looseygooseyrobotics/goosebrain/3dmodels/XT30PW-M.step

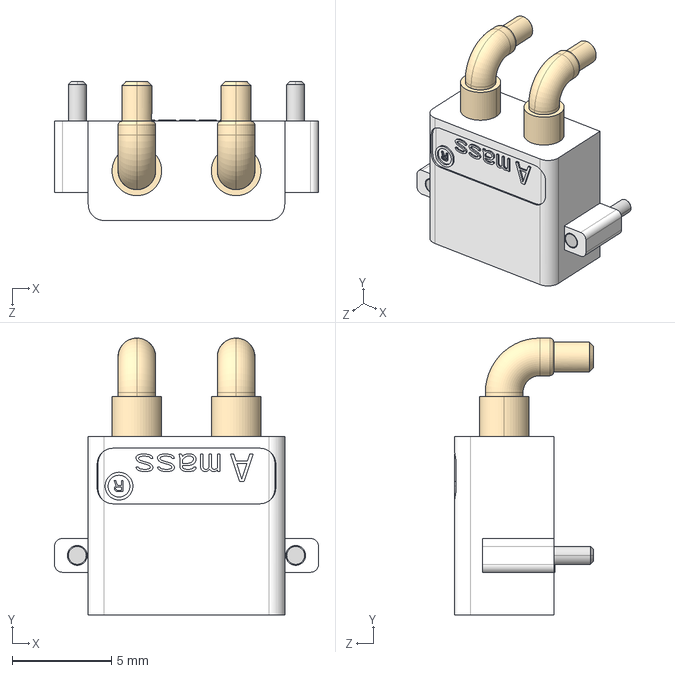
[picture p1: CAD file, 2026-11-12]
3dmodels/XT30PW-M.step
13.3 x 13.9 x 7.00 mm
