looseygooseyrobotics/goosebrain/3dmodels/2011-3X06G00RB.step

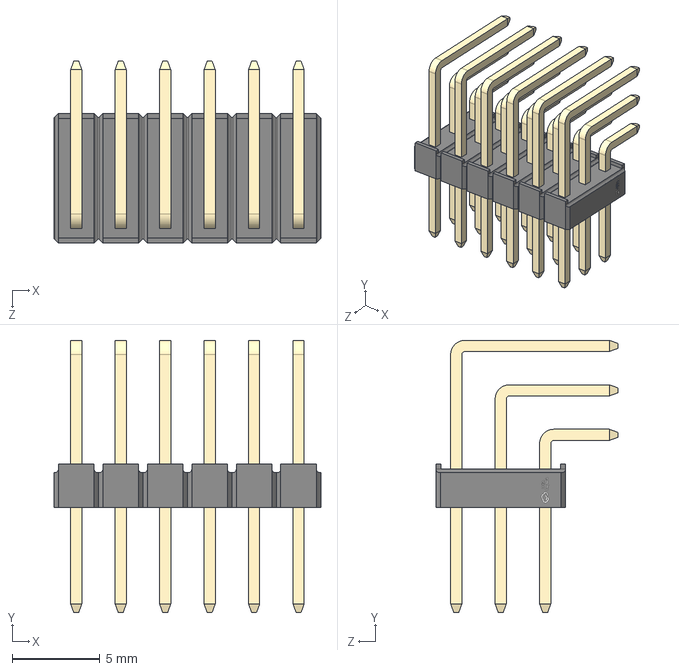
[picture p2: CAD file, 2026-11-12]
3dmodels/2011-3X06G00RB.step
15.2 x 15.6 x 10.4 mm
