looseygooseyrobotics/goosebrain/3dmodels/SK12D07VG4.step

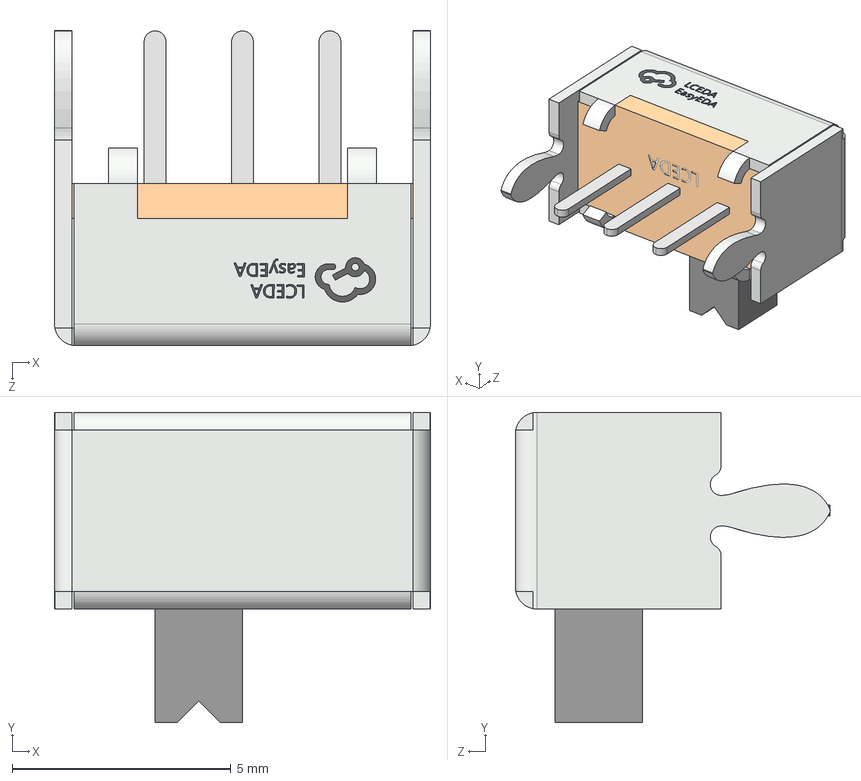
[picture p3: CAD file, 2026-11-12]
3dmodels/SK12D07VG4.step
8.60 x 7.10 x 7.19 mm
