looseygooseyrobotics/goosebrain/3dmodels/SKRTLAE010.step

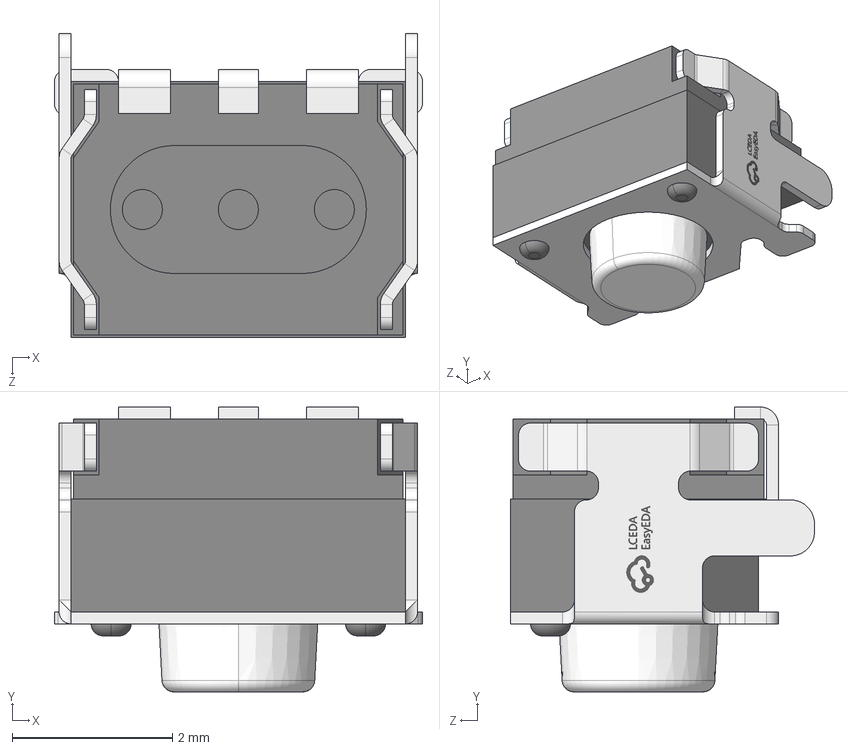
[picture p4: CAD file, 2026-11-12]
3dmodels/SKRTLAE010.step
4.60 x 3.56 x 3.80 mm
