looseygooseyrobotics/goosebrain/goosebrain.kicad_pcb

## KiCad design goosebrain.kicad_pcb (2026-11-12)

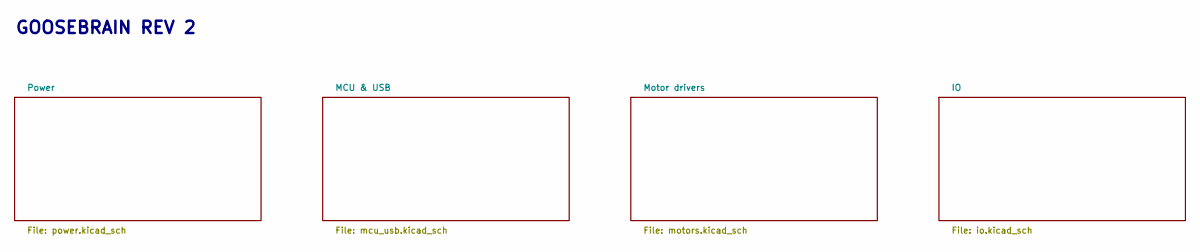
[picture p5: schematic goosebrain.kicad_sch]

Notes on the sheet:
GOOSEBRAIN REV 2

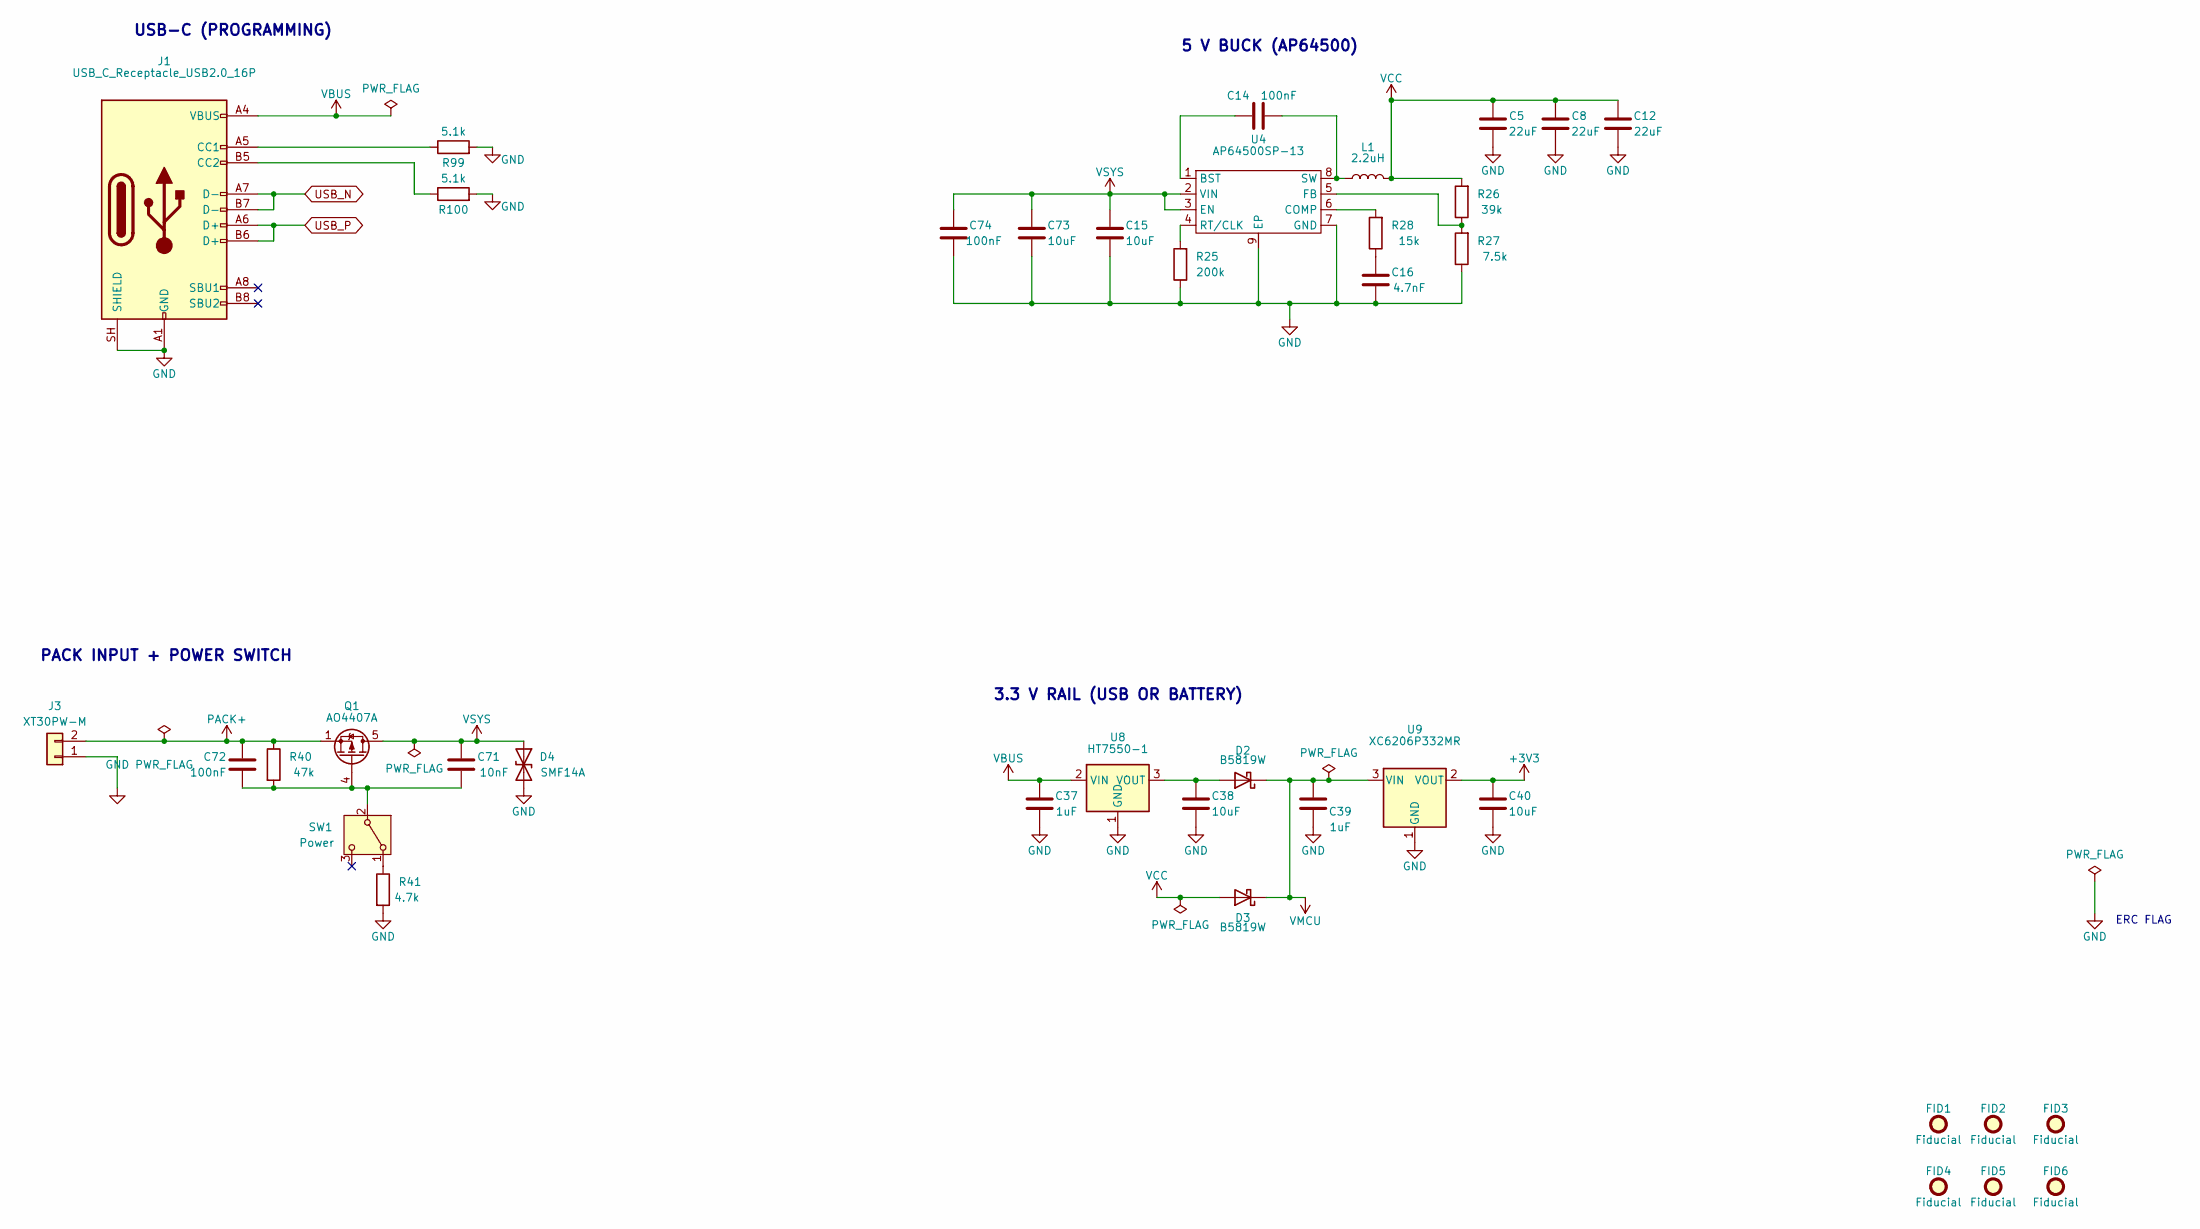
[picture p6: schematic power.kicad_sch]

Parts:
C5, C8, C12: 22uF; C_1206_3216Metric; MPN CL31A226KPHNNNE; LCSC Part # C5672
C14, C72: 100nF; C_0805_2012Metric; MPN CC0805KRX7R9BB104; LCSC Part # C49678
C15, C73: 10uF; C_0805_2012Metric; MPN CL21A106KAYNNNE; LCSC Part # C15850
C16: 4.7nF; C_0402_1005Metric; MPN 0402B472K500NT; LCSC Part # C1538
C37: 1uF; C_0603_1608Metric; MPN CL10A105KB8NNNC; LCSC Part # C15849
C38, C40: 10uF; C_0603_1608Metric; MPN CL10A106KP8NNNC; LCSC Part # C19702
C39: 1uF; C_0402_1005Metric; MPN CL05A105KA5NQNC; LCSC Part # C52923
C71: 10nF; C_0402_1005Metric; MPN CL05B103KB5NNNC; LCSC Part # C15195
C74: 100nF; C_0402_1005Metric; MPN CL05B104KB54PNC; LCSC Part # C307331
D2, D3: B5819W; D_SOD-123; MPN B5819W; LCSC Part # C64885
D4: SMF14A; D_SMF; MPN SMF14A; LCSC Part # C207256
FID1, FID2, FID3, FID4, FID5, FID6: Fiducial; Fiducial_1mm_Mask2mm
J1: USB_C_Receptacle_USB2.0_16P; USB_C_Receptacle_ShouHan_TYPE-C16PIN; MPN TYPE-C16PIN; LCSC Part # C393939
J3: XT30PW-M; AMASS_XT30PW-M_1x02_P2.50mm_Horizontal; MPN XT30PW-M30.G.Y; LCSC Part # C431092
L1: 2.2uH; L_ZengYi_HMS0530; MPN HMS0530-2R2M; LCSC Part # C18734448
Q1: AO4407A; SOIC-8_3.9x4.9mm_P1.27mm; MPN AO4407A; LCSC Part # C2841482
R25: 200k; R_0402_1005Metric; MPN 0402WGF2003TCE; LCSC Part # C25764
R26: 39k; R_0402_1005Metric; MPN 0402WGF3902TCE; LCSC Part # C25783
R27: 7.5k; R_0402_1005Metric; MPN 0402WGF7501TCE; LCSC Part # C25918
R28: 15k; R_0402_1005Metric; MPN 0402WGF1502TCE; LCSC Part # C25756
R40: 47k; R_0402_1005Metric; MPN 0402WGF4702TCE; LCSC Part # C25792
R41: 4.7k; R_0402_1005Metric; MPN 0402WGF4701TCE; LCSC Part # C25900
R99, R100: 5.1k; R_0402_1005Metric; MPN 0402WGF5101TCE; LCSC Part # C25905
SW1: Power; SW_SPDT_ShouHan_SK12D07VG4; MPN SK12D07VG4; LCSC Part # C393937
U4: AP64500SP-13; Diodes_SO-8EP; MPN AP64500SP-13; LCSC Part # C2070920
U8: HT7550-1; SOT-89-3; MPN HT7550-1; LCSC Part # C16106
U9: XC6206P332MR; SOT-23-3; MPN XC6206P332MR-G; LCSC Part # C5446

Connections:
+3V3: C40.1, U9.2 (VOUT); also elsewhere on the board
/Power/CC1: J1.A5 (CC1), R99.1
/Power/CC2: J1.B5 (CC2), R100.1
GND: C5.2, C8.2, C12.2, C15.1, C16.1, C37.2, C38.2, C39.2, C40.2, C73.1, C74.1, D4.2 (A2), J1.A1 (GND), J1.A12 (GND), J1.B1 (GND), J1.B12 (GND), J1.SH (SHIELD), J3.1, R25.1, R27.1, R41.2, R99.2, R100.2, U4.7 (GND), U4.9 (EP), U8.1 (GND), U9.1 (GND); also elsewhere on the board
unnamed: C16.2, R28.1
unnamed: C38.1, D2.2 (A), U8.3 (VOUT)
unnamed: C71.1, C72.2, Q1.4 (G), R40.2, SW1.2 (B)
unnamed: R41.1, SW1.1 (A)
unnamed: C14.2, U4.1 (BST)
unnamed: R28.2, U4.6 (COMP)
unnamed: R26.1, R27.2, U4.5 (FB)
unnamed: R25.2, U4.4 (RT/CLK)
unnamed: C14.1, L1.1, U4.8 (SW)
PACK+: C72.1, J3.2, Q1.1 (S), Q1.2 (S), Q1.3 (S), R40.1
VBUS: C37.1, J1.A4 (VBUS), J1.A9 (VBUS), J1.B4 (VBUS), J1.B9 (VBUS), U8.2 (VIN)
VCC: C5.1, C8.1, C12.1, D3.2 (A), L1.2, R26.2; also elsewhere on the board
VMCU: C39.1, D2.1 (K), D3.1 (K), U9.3 (VIN); also elsewhere on the board
VSYS: C15.2, C71.2, C73.2, C74.2, D4.1 (A1), Q1.5 (D), Q1.6 (D), Q1.7 (D), Q1.8 (D), U4.2 (VIN), U4.3 (EN); also elsewhere on the board

Notes on the sheet:
ERC FLAG
3.3 V RAIL (USB OR BATTERY)
5 V BUCK (AP64500)
USB-C (PROGRAMMING)
PACK INPUT + POWER SWITCH

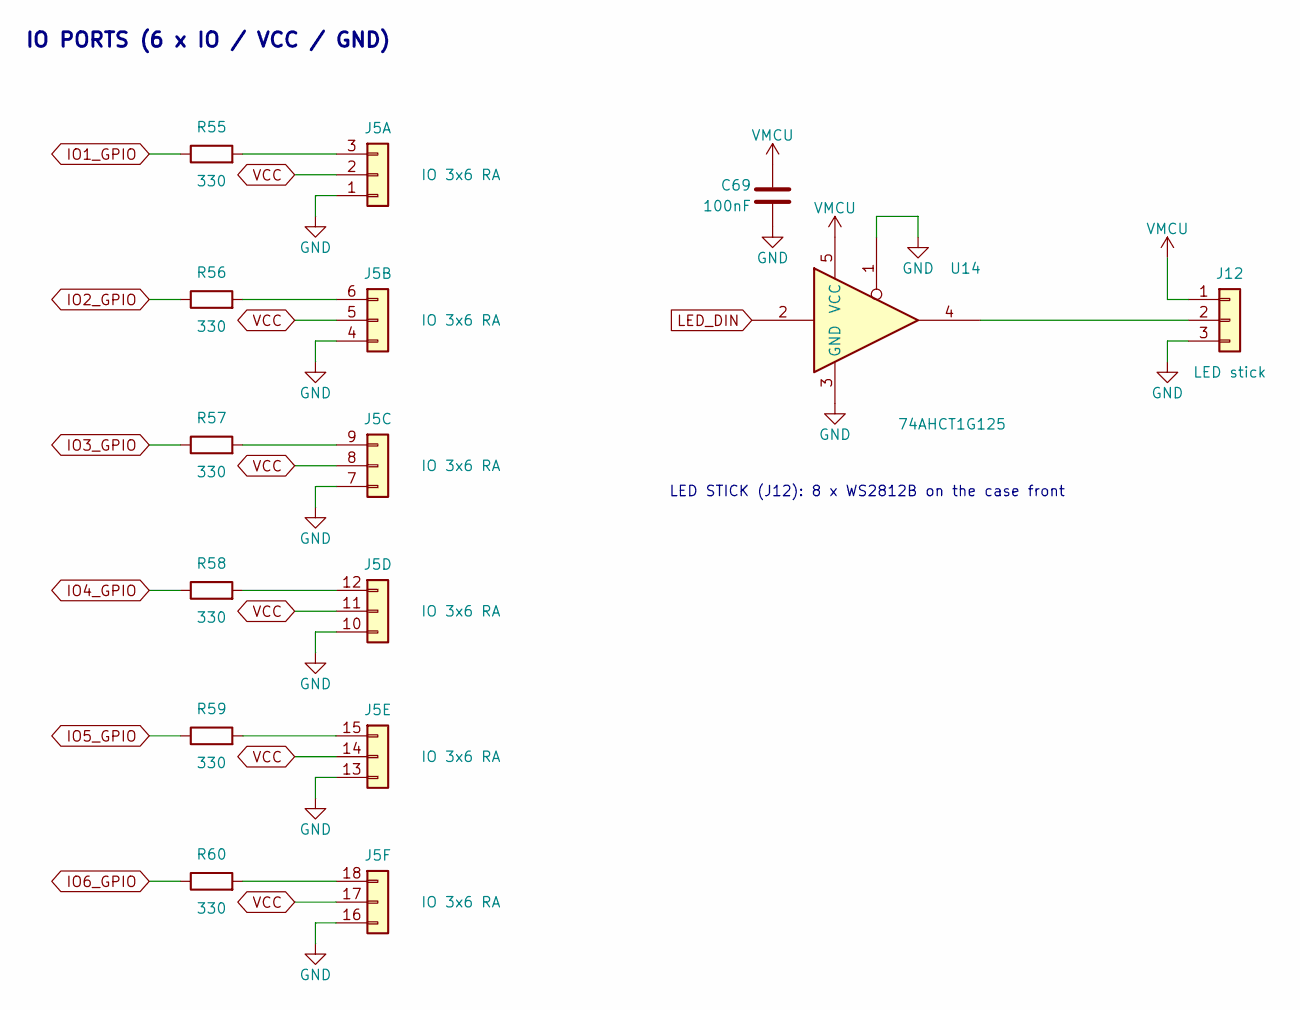
[picture p7: schematic io.kicad_sch]

Parts:
C69: 100nF; C_0402_1005Metric; MPN CL05B104KO5NNNC; LCSC Part # C1525
J5: IO 3x6 RA; PinHeader_3x06_P2.54mm_Horizontal_WingTAT; MPN 2011-3X06G00RB; LCSC Part # C51953246
J12: LED stick; JST_PH_B3B-PH-K_1x03_P2.00mm_Vertical; MPN B3B-PH-K-S(LF)(SN); LCSC Part # C131339
R55, R56, R57, R58, R59, R60: 330; R_0402_1005Metric; MPN 0402WGF3300TCE; LCSC Part # C25104
U14: 74AHCT1G125; SOT-23-5; MPN SN74AHCT1G125DBVR; LCSC Part # C20617903

Connections:
GND: C69.2, J5.1 (GND), J5.4 (GND), J5.7 (GND), J5.10 (GND), J5.13 (GND), J5.16 (GND), J12.3, U14.1, U14.3 (GND); also elsewhere on the board
IO1_GPIO: R55.1; also elsewhere on the board
IO2_GPIO: R56.1; also elsewhere on the board
IO3_GPIO: R57.1; also elsewhere on the board
IO4_GPIO: R58.1; also elsewhere on the board
IO5_GPIO: R59.1; also elsewhere on the board
IO6_GPIO: R60.1; also elsewhere on the board
LED_DIN: U14.2; also elsewhere on the board
unnamed: J5.3 (SIG), R55.2
unnamed: J5.6 (SIG), R56.2
unnamed: J5.9 (SIG), R57.2
unnamed: J5.12 (SIG), R58.2
unnamed: J5.15 (SIG), R59.2
unnamed: J5.18 (SIG), R60.2
unnamed: J12.2, U14.4
VCC: J5.2 (5V), J5.5 (5V), J5.8 (5V), J5.11 (5V), J5.14 (5V), J5.17 (5V); also elsewhere on the board
VMCU: C69.1, J12.1, U14.5 (VCC); also elsewhere on the board

Notes on the sheet:
LED STICK (J12): 8 x WS2812B on the case front
IO PORTS (6 x IO / VCC / GND)

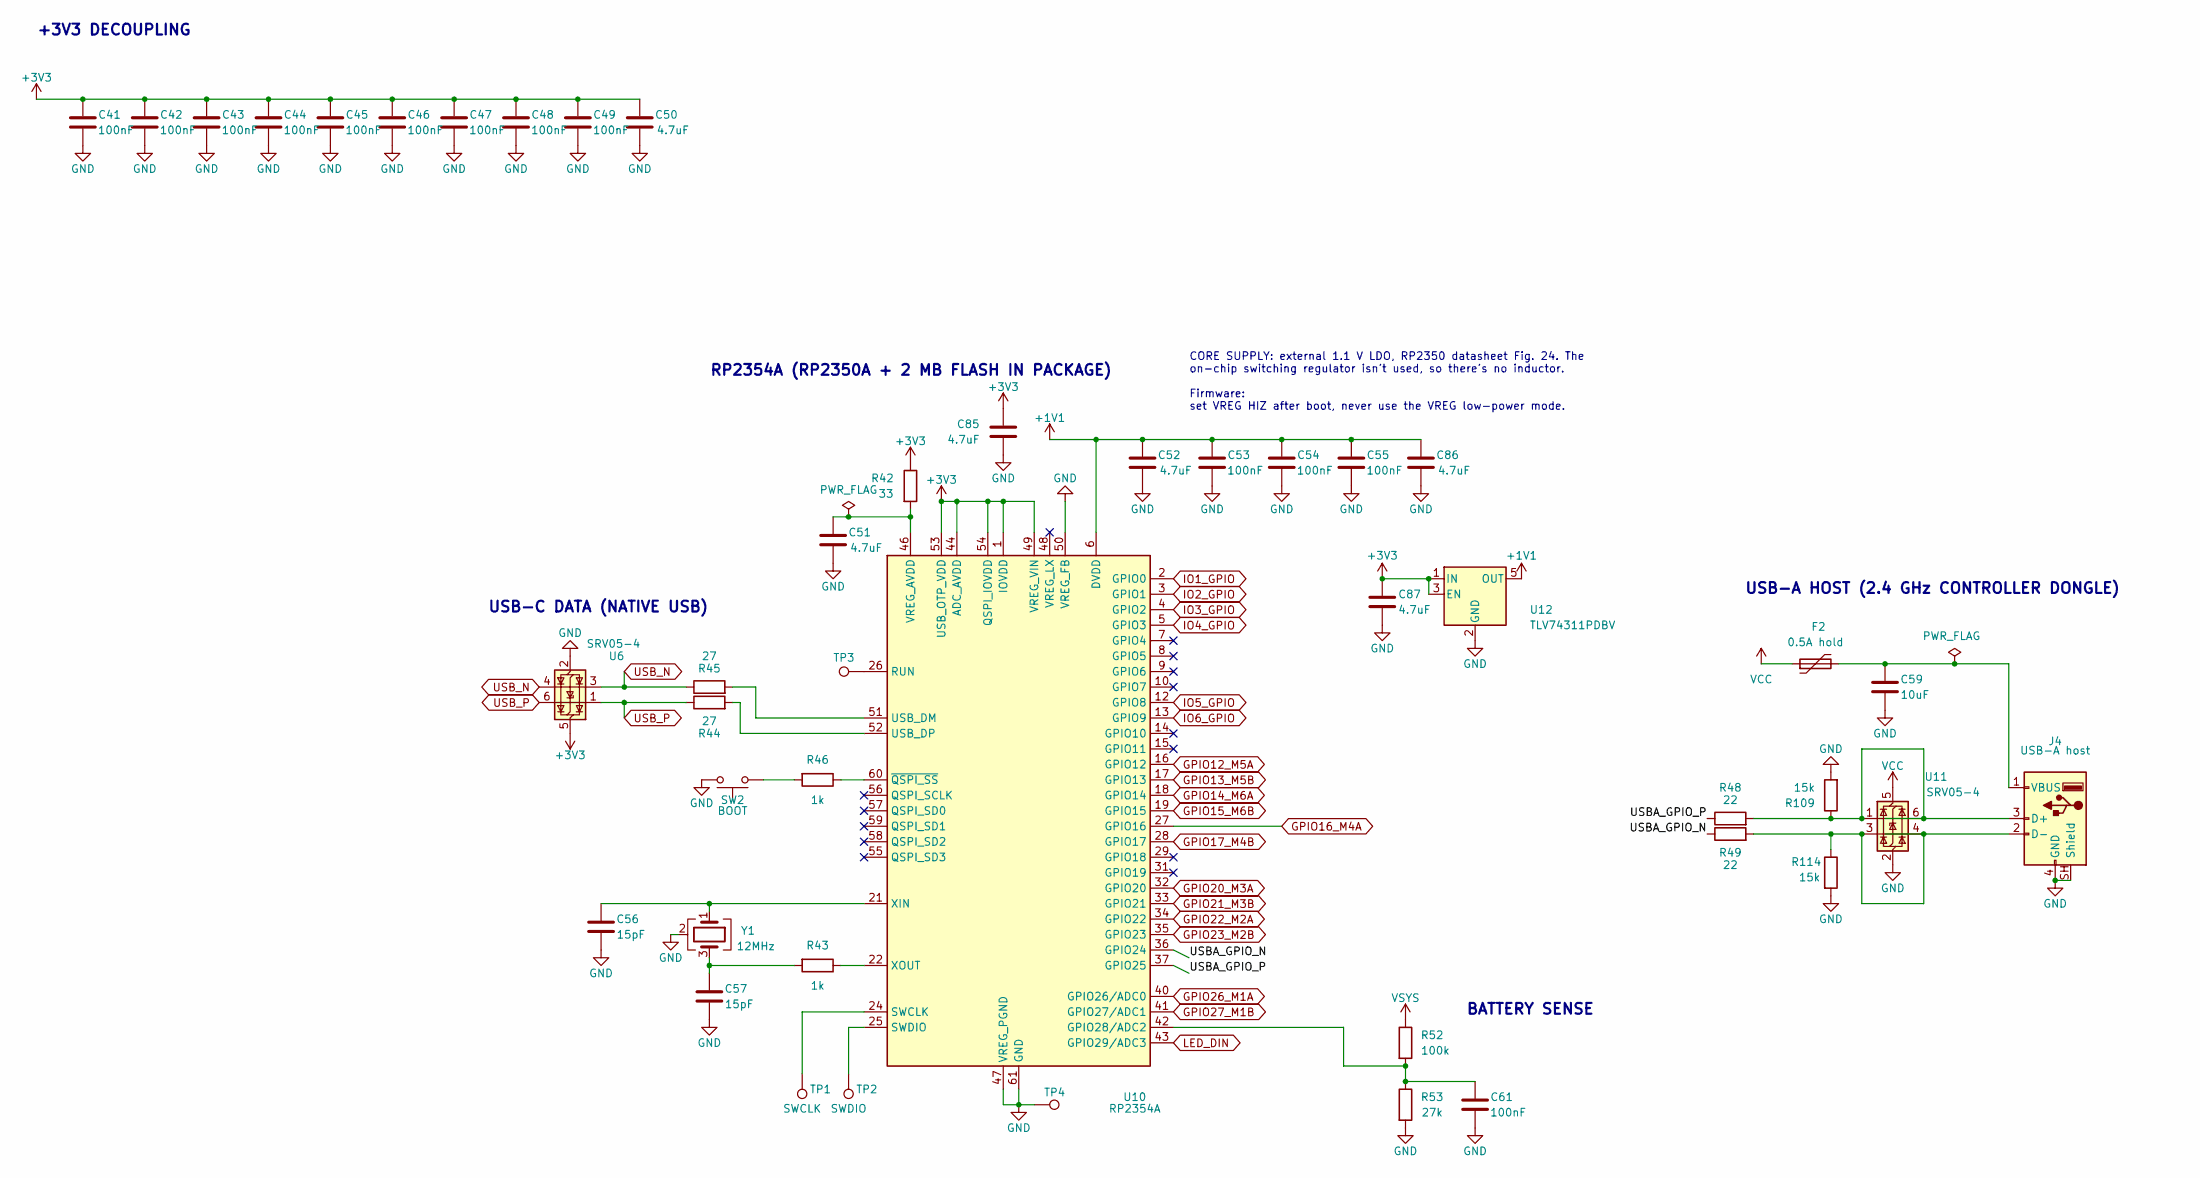
[picture p8: schematic mcu_usb.kicad_sch]

Parts:
C41, C42, C43, C44, C45, C46, C47, C48, C49, C53, C54, C55, C61: 100nF; C_0402_1005Metric; MPN CL05B104KO5NNNC; LCSC Part # C1525
C50, C51, C52, C85, C86, C87: 4.7uF; C_0402_1005Metric; MPN CL05A475MP5NRNC; LCSC Part # C23733
C56, C57: 15pF; C_0402_1005Metric; MPN 0402CG150J500NT; LCSC Part # C1548
C59: 10uF; C_0805_2012Metric; MPN CL21A106KAYNNNE; LCSC Part # C15850
F2: 0.5A hold; Fuse_1206_3216Metric; MPN JK-nSMD050-16; LCSC Part # C2680506
J4: USB-A host; USB_A_ShouHan_AF90_WJDG; MPN AF 90 WJDG; LCSC Part # C456018
R42: 33; R_0402_1005Metric; MPN 0402WGF330JTCE; LCSC Part # C25105
R43, R46: 1k; R_0402_1005Metric; MPN 0402WGF1001TCE; LCSC Part # C11702
R44, R45: 27; R_0603_1608Metric; MPN 0603WAF270JT5E; LCSC Part # C25190
R48, R49: 22; R_0402_1005Metric; MPN 0402WGF220JTCE; LCSC Part # C25092
R52: 100k; R_0402_1005Metric; MPN 0402WGF1003TCE; LCSC Part # C25741
R53: 27k; R_0402_1005Metric; MPN 0402WGF2702TCE; LCSC Part # C25771
R109, R114: 15k; R_0402_1005Metric; MPN 0402WGF1502TCE; LCSC Part # C25756
SW2: BOOT; SW_Push_1P1T-MP_NO_Horizontal_Alps_SKRTLAE010_JLC; MPN SKRTLAE010; LCSC Part # C110293
TP1: SWCLK; TestPoint_Pad_D1.0mm
TP2: SWDIO; TestPoint_Pad_D1.0mm
TP3: RUN; TestPoint_Pad_D1.0mm
TP4: GND; TestPoint_Pad_D1.0mm
U6, U11: SRV05-4; SOT-23-6; MPN SRV05-4; LCSC Part # C7420376
U10: RP2354A; QFN-60-1EP_7x7mm_P0.4mm_EP3.4x3.4mm; MPN RP2354A; LCSC Part # C41378174
U12: TLV74311PDBV; SOT-23-5; MPN TLV74311PDBVR; LCSC Part # C485147
Y1: 12MHz; Crystal_SMD_3225-4Pin_3.2x2.5mm; MPN ABM8-272-T3; LCSC Part # C20625731

Connections:
+1V1: C52.1, C53.1, C54.1, C55.1, C86.1, U10.6 (DVDD), U10.23 (DVDD), U10.39 (DVDD), U12.5 (OUT)
+3V3: C41.1, C42.1, C43.1, C44.1, C45.1, C46.1, C47.1, C48.1, C49.1, C50.1, C85.1, C87.1, R42.1, U6.5 (VP), U10.1 (IOVDD), U10.11 (IOVDD), U10.20 (IOVDD), U10.30 (IOVDD), U10.38 (IOVDD), U10.44 (ADC_AVDD), U10.45 (IOVDD), U10.49 (VREG_VIN), U10.53 (USB_OTP_VDD), U10.54 (QSPI_IOVDD), U12.1 (IN), U12.3 (EN); also elsewhere on the board
/MCU & USB/BAT_SENSE: C61.1, R52.2, R53.1, U10.42 (GPIO28/ADC2)
/MCU & USB/RUN: TP3.1 (1_1), U10.26 (RUN)
/MCU & USB/USBA_GPIO_N: R49.1, U10.36 (GPIO24)
/MCU & USB/USBA_GPIO_P: R48.1, U10.37 (GPIO25)
/MCU & USB/USBA_N: J4.2 (D-), R49.2, R114.1, U11.3 (IO2), U11.4 (IO3)
/MCU & USB/USBA_P: J4.3 (D+), R48.2, R109.1, U11.1 (IO1), U11.6 (IO4)
GND: C41.2, C42.2, C43.2, C44.2, C45.2, C46.2, C47.2, C48.2, C49.2, C50.2, C51.2, C52.2, C53.2, C54.2, C55.2, C56.2, C57.2, C59.2, C61.2, C85.2, C86.2, C87.2, J4.4 (GND), J4.SH (Shield), R53.2, R109.2, R114.2, SW2.2, TP4.1 (1_1), U6.2 (VN), U10.47 (VREG_PGND), U10.50 (VREG_FB), U10.61 (GND), U11.2 (VN), U12.2 (GND), Y1.2 (G), Y1.4 (G); also elsewhere on the board
GPIO12_M5A: U10.16 (GPIO12); also elsewhere on the board
GPIO13_M5B: U10.17 (GPIO13); also elsewhere on the board
GPIO14_M6A: U10.18 (GPIO14); also elsewhere on the board
GPIO15_M6B: U10.19 (GPIO15); also elsewhere on the board
GPIO16_M4A: U10.27 (GPIO16); also elsewhere on the board
GPIO17_M4B: U10.28 (GPIO17); also elsewhere on the board
GPIO20_M3A: U10.32 (GPIO20); also elsewhere on the board
GPIO21_M3B: U10.33 (GPIO21); also elsewhere on the board
GPIO22_M2A: U10.34 (GPIO22); also elsewhere on the board
GPIO23_M2B: U10.35 (GPIO23); also elsewhere on the board
GPIO26_M1A: U10.40 (GPIO26/ADC0); also elsewhere on the board
GPIO27_M1B: U10.41 (GPIO27/ADC1); also elsewhere on the board
IO1_GPIO: U10.2 (GPIO0); also elsewhere on the board
IO2_GPIO: U10.3 (GPIO1); also elsewhere on the board
IO3_GPIO: U10.4 (GPIO2); also elsewhere on the board
IO4_GPIO: U10.5 (GPIO3); also elsewhere on the board
IO5_GPIO: U10.12 (GPIO8); also elsewhere on the board
IO6_GPIO: U10.13 (GPIO9); also elsewhere on the board
LED_DIN: U10.43 (GPIO29/ADC3); also elsewhere on the board
unnamed: C57.1, R43.2, Y1.3
unnamed: C59.1, F2.2, J4.1 (VBUS)
unnamed: R46.2, SW2.1
unnamed: TP1.1 (1_1), U10.24 (SWCLK)
unnamed: TP2.1 (1_1), U10.25 (SWDIO)
unnamed: C51.1, R42.2, U10.46 (VREG_AVDD)
unnamed: C56.1, U10.21 (XIN), Y1.1
unnamed: R43.1, U10.22 (XOUT)
unnamed: R46.1, U10.60 (~QSPI_SS)
VCC: F2.1, U11.5 (VP); also elsewhere on the board
VSYS: R52.1; also elsewhere on the board

Notes on the sheet:
RP2354A (RP2350A + 2 MB FLASH IN PACKAGE)
+3V3 DECOUPLING
CORE SUPPLY: external 1.1 V LDO, RP2350 datasheet Fig. 24. The on-chip switching regulator isn't used, so there's no inductor. Firmware: set VREG HIZ after boot, never use the VREG low-power mode.
BATTERY SENSE
USB-C DATA (NATIVE USB)
USB-A HOST (2.4 GHz CONTROLLER DONGLE)

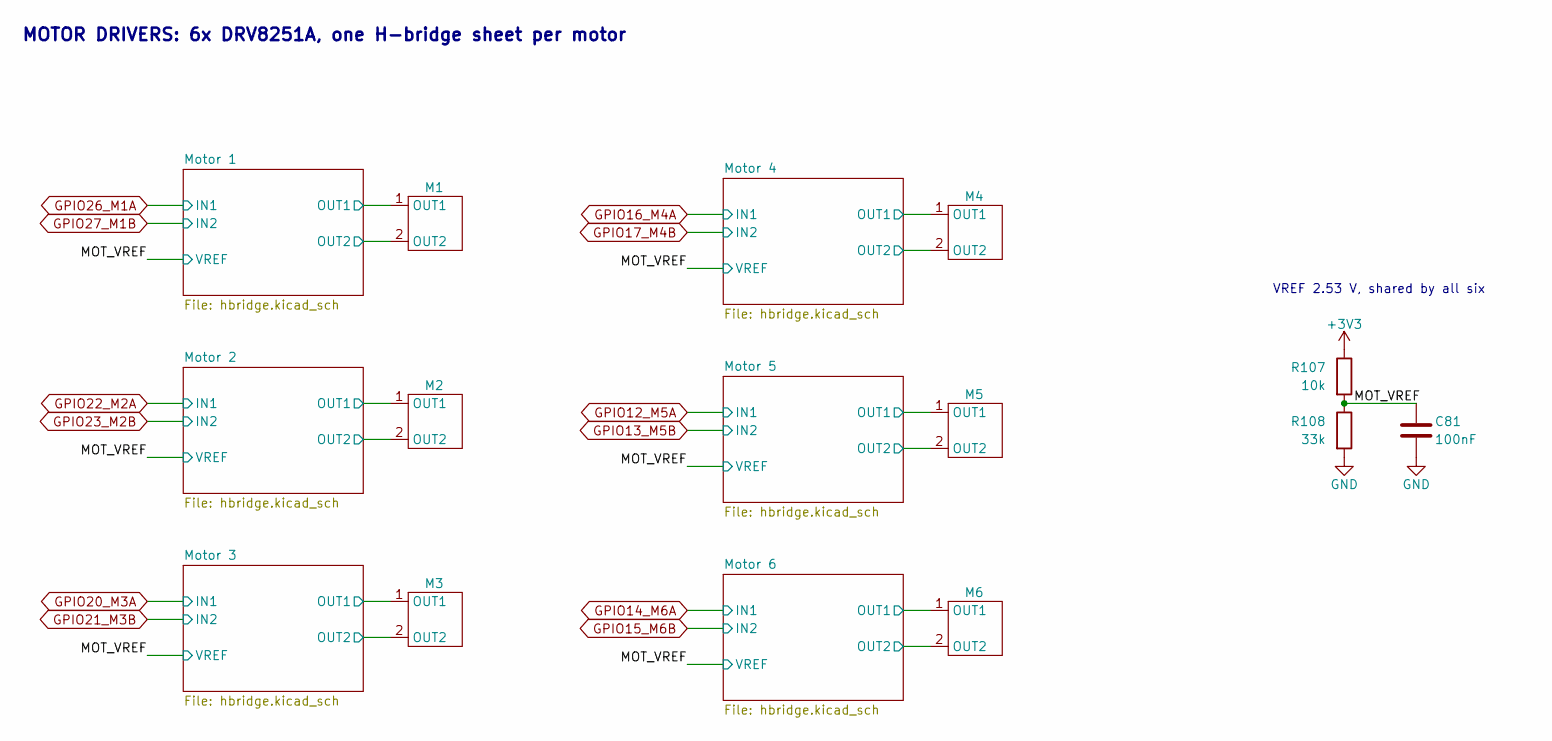
[picture p9: schematic motors.kicad_sch]

Parts:
C81: 100nF; C_0402_1005Metric; MPN CL05B104KO5NNNC; LCSC Part # C1525
M1, M2, M3, M4, M5, M6: JST_PH_S2B-PH-K_1x02_P2.00mm_Horizontal; MPN S2B-PH-K-S(LF)(SN); LCSC Part # C173752
R107: 10k; R_0402_1005Metric; MPN 0402WGF1002TCE; LCSC Part # C25744
R108: 33k; R_0402_1005Metric; MPN 0402WGF3302TCE; LCSC Part # C25779

Connections:
+3V3: R107.1; also elsewhere on the board
/Motor drivers/MOT_VREF: C81.1, R107.2, R108.1; also elsewhere on the board
/Motor drivers/Motor 1/OUT1: M1.1 (OUT1); also elsewhere on the board
/Motor drivers/Motor 1/OUT2: M1.2 (OUT2); also elsewhere on the board
/Motor drivers/Motor 2/OUT1: M2.1 (OUT1); also elsewhere on the board
/Motor drivers/Motor 2/OUT2: M2.2 (OUT2); also elsewhere on the board
/Motor drivers/Motor 3/OUT1: M3.1 (OUT1); also elsewhere on the board
/Motor drivers/Motor 3/OUT2: M3.2 (OUT2); also elsewhere on the board
/Motor drivers/Motor 4/OUT1: M4.1 (OUT1); also elsewhere on the board
/Motor drivers/Motor 4/OUT2: M4.2 (OUT2); also elsewhere on the board
/Motor drivers/Motor 5/OUT1: M5.1 (OUT1); also elsewhere on the board
/Motor drivers/Motor 5/OUT2: M5.2 (OUT2); also elsewhere on the board
/Motor drivers/Motor 6/OUT1: M6.1 (OUT1); also elsewhere on the board
/Motor drivers/Motor 6/OUT2: M6.2 (OUT2); also elsewhere on the board
GND: C81.2, R108.2; also elsewhere on the board

Notes on the sheet:
VREF 2.53 V, shared by all six
MOTOR DRIVERS: 6x DRV8251A, one H-bridge sheet per motor

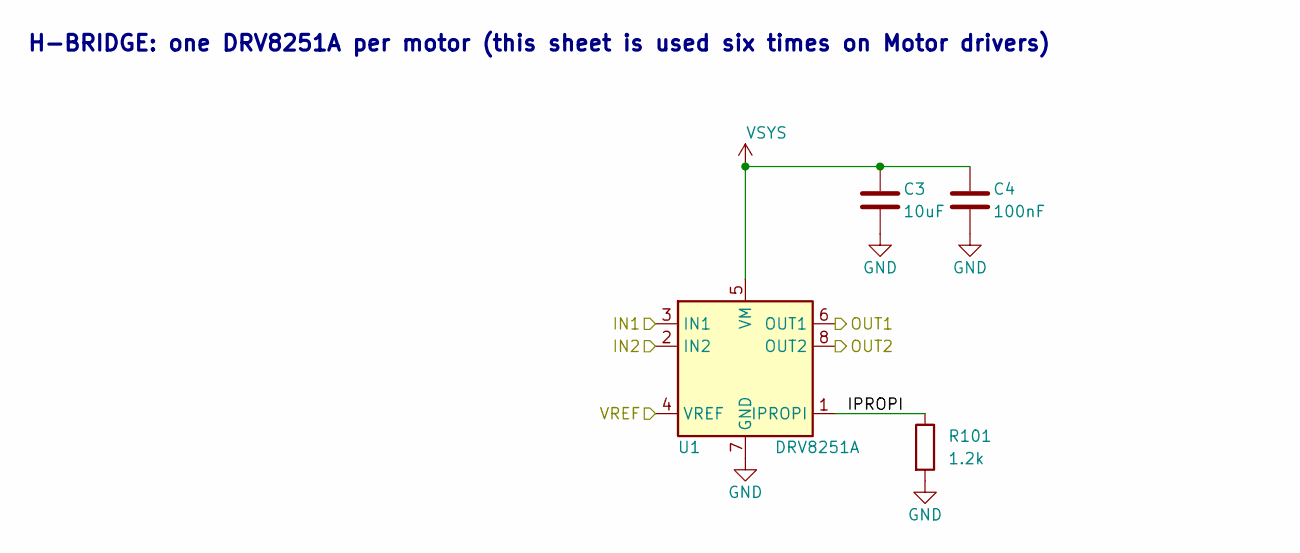
[picture p10: schematic hbridge.kicad_sch]

Parts:
C3: 10uF; C_0805_2012Metric; MPN CL21A106KAYNNNE; LCSC Part # C15850
C4: 100nF; C_0805_2012Metric; MPN CC0805KRX7R9BB104; LCSC Part # C49678
R101: 1.2k; R_0402_1005Metric; MPN 0402WGF1201TCE; LCSC Part # C25862
U1: DRV8251A; Texas_HTSOP-8-1EP_3.9x4.9mm_P1.27mm_EP2.95x4.9mm_Mask2.4x3.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; MPN DRV8251ADDAR; LCSC Part # C5218844

Connections:
/Motor drivers/MOT_VREF: U1.4 (VREF); also elsewhere on the board
/Motor drivers/Motor 1/IPROPI: R101.1, U1.1 (IPROPI)
/Motor drivers/Motor 1/OUT1: U1.6 (OUT1); also elsewhere on the board
/Motor drivers/Motor 1/OUT2: U1.8 (OUT2); also elsewhere on the board
GND: C3.2, C4.2, R101.2, U1.7 (GND), U1.9 (GND); also elsewhere on the board
GPIO26_M1A: U1.3 (IN1); also elsewhere on the board
GPIO27_M1B: U1.2 (IN2); also elsewhere on the board
VSYS: C3.1, C4.1, U1.5 (VM); also elsewhere on the board

Parts of its further copies:
C6, C10, C75, C77, C79: 10uF; C_0805_2012Metric; MPN CL21A106KAYNNNE; LCSC Part # C15850
C7, C11, C76, C78, C80: 100nF; C_0805_2012Metric; MPN CC0805KRX7R9BB104; LCSC Part # C49678
R102, R103, R104, R105, R106: 1.2k; R_0402_1005Metric; MPN 0402WGF1201TCE; LCSC Part # C25862
U2, U3, U15, U16, U17: DRV8251A; Texas_HTSOP-8-1EP_3.9x4.9mm_P1.27mm_EP2.95x4.9mm_Mask2.4x3.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; MPN DRV8251ADDAR; LCSC Part # C5218844

Connections of its further copies:
/Motor drivers/MOT_VREF: U2.4 (VREF), U3.4 (VREF), U15.4 (VREF), U16.4 (VREF), U17.4 (VREF); also elsewhere on the board
/Motor drivers/Motor 2/IPROPI: R102.1, U15.1 (IPROPI)
/Motor drivers/Motor 2/OUT1: U15.6 (OUT1); also elsewhere on the board
/Motor drivers/Motor 2/OUT2: U15.8 (OUT2); also elsewhere on the board
/Motor drivers/Motor 3/IPROPI: R103.1, U2.1 (IPROPI)
/Motor drivers/Motor 3/OUT1: U2.6 (OUT1); also elsewhere on the board
/Motor drivers/Motor 3/OUT2: U2.8 (OUT2); also elsewhere on the board
/Motor drivers/Motor 4/IPROPI: R104.1, U16.1 (IPROPI)
/Motor drivers/Motor 4/OUT1: U16.6 (OUT1); also elsewhere on the board
/Motor drivers/Motor 4/OUT2: U16.8 (OUT2); also elsewhere on the board
/Motor drivers/Motor 5/IPROPI: R105.1, U3.1 (IPROPI)
/Motor drivers/Motor 5/OUT1: U3.6 (OUT1); also elsewhere on the board
/Motor drivers/Motor 5/OUT2: U3.8 (OUT2); also elsewhere on the board
/Motor drivers/Motor 6/IPROPI: R106.1, U17.1 (IPROPI)
/Motor drivers/Motor 6/OUT1: U17.6 (OUT1); also elsewhere on the board
/Motor drivers/Motor 6/OUT2: U17.8 (OUT2); also elsewhere on the board
GND: C6.2, C7.2, C10.2, C11.2, C75.2, C76.2, C77.2, C78.2, C79.2, C80.2, R102.2, R103.2, R104.2, R105.2, R106.2, U2.7 (GND), U2.9 (GND), U3.7 (GND), U3.9 (GND), U15.7 (GND), U15.9 (GND), U16.7 (GND), U16.9 (GND), U17.7 (GND), U17.9 (GND); also elsewhere on the board
GPIO12_M5A: U3.3 (IN1); also elsewhere on the board
GPIO13_M5B: U3.2 (IN2); also elsewhere on the board
GPIO14_M6A: U17.3 (IN1); also elsewhere on the board
GPIO15_M6B: U17.2 (IN2); also elsewhere on the board
GPIO16_M4A: U16.3 (IN1); also elsewhere on the board
GPIO17_M4B: U16.2 (IN2); also elsewhere on the board
GPIO20_M3A: U2.3 (IN1); also elsewhere on the board
GPIO21_M3B: U2.2 (IN2); also elsewhere on the board
GPIO22_M2A: U15.3 (IN1); also elsewhere on the board
GPIO23_M2B: U15.2 (IN2); also elsewhere on the board
VSYS: C6.1, C7.1, C10.1, C11.1, C75.1, C76.1, C77.1, C78.1, C79.1, C80.1, U2.5 (VM), U3.5 (VM), U15.5 (VM), U16.5 (VM), U17.5 (VM); also elsewhere on the board

Notes on the sheet:
H-BRIDGE: one DRV8251A per motor (this sheet is used six times on Motor drivers)

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
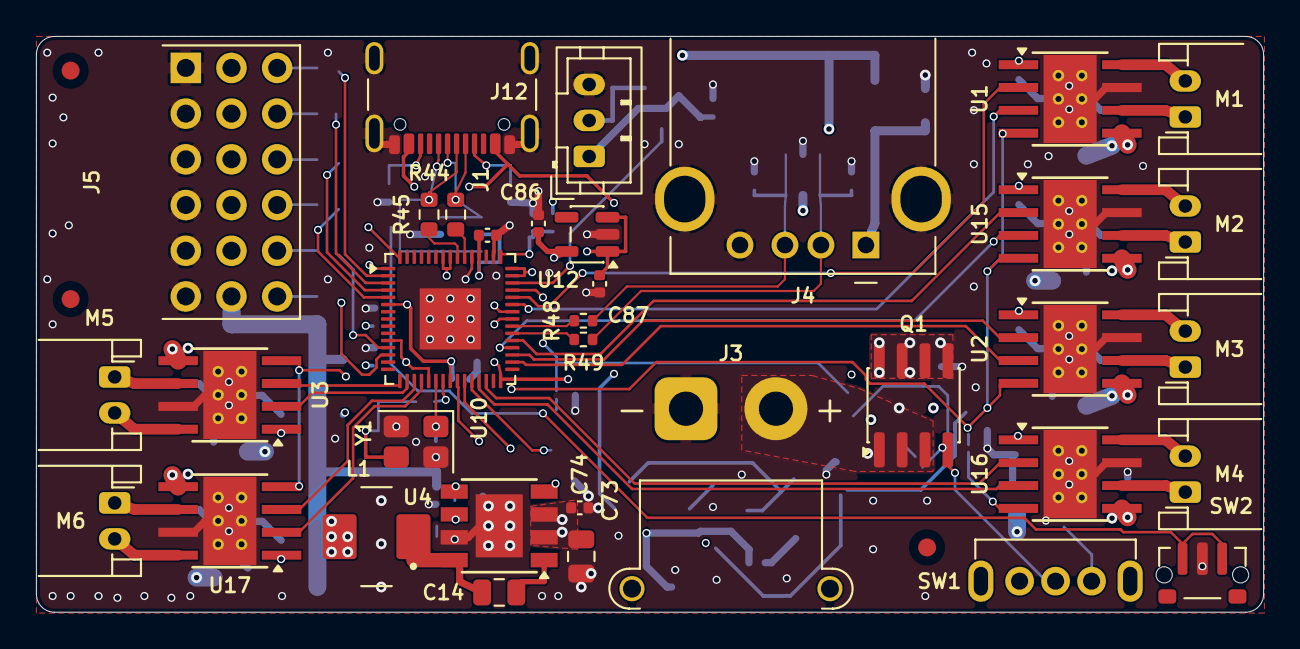
[picture p11: board goosebrain.kicad_pcb from above]

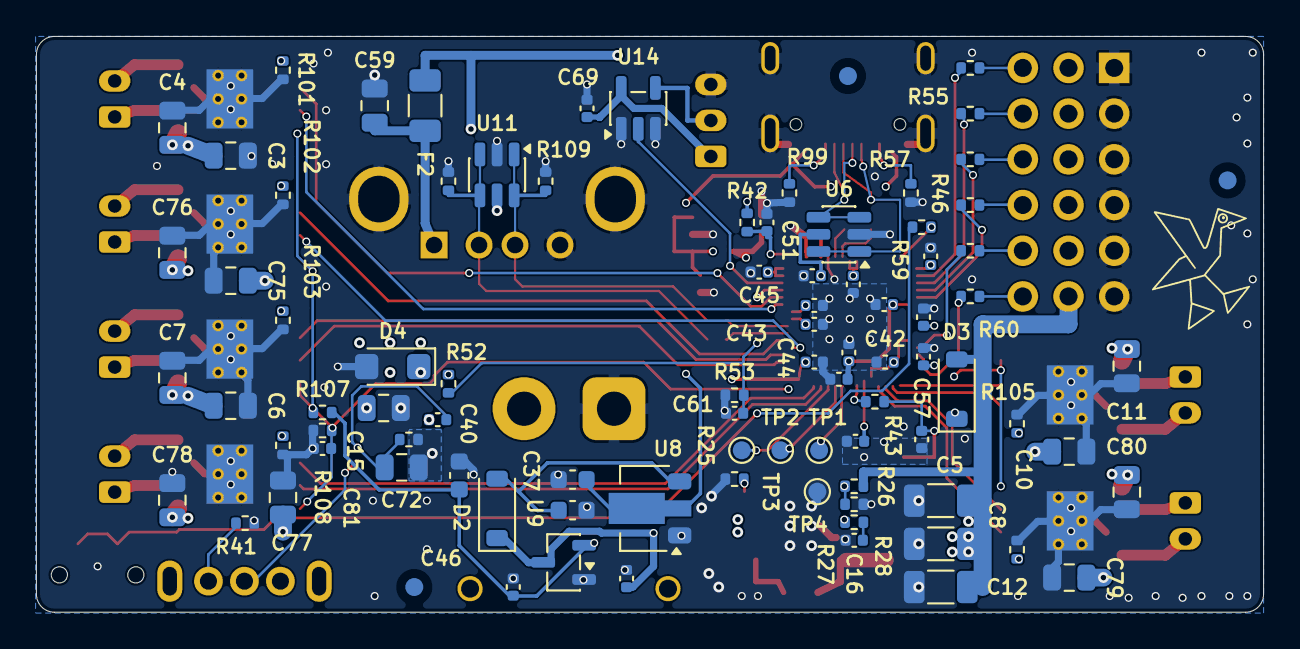
[picture p12: board goosebrain.kicad_pcb from below]

Board: 6 copper layers, 68.2 x 32.0 mm, 127 parts (89 on the bottom side), 83 nets.
